Stan1806/AquaController_2014/Sources/AquaControl 2014 (MFC)/AquaControl 2014/about.bmp

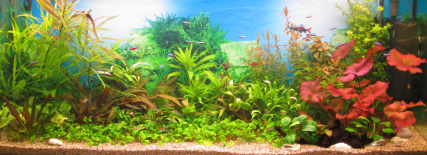
Sources/AquaControl 2014 (MFC)/AquaControl 2014/about.bmp
