Stan1806/AquaController_2014/Sources/Help/About program.png

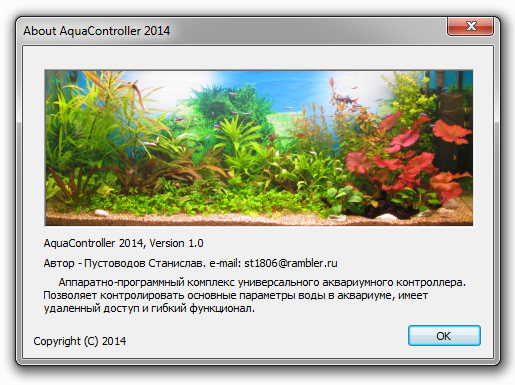
Sources/Help/About program.png
