Stan1806/AquaController_2014/Радиомодуль (схема).pdf

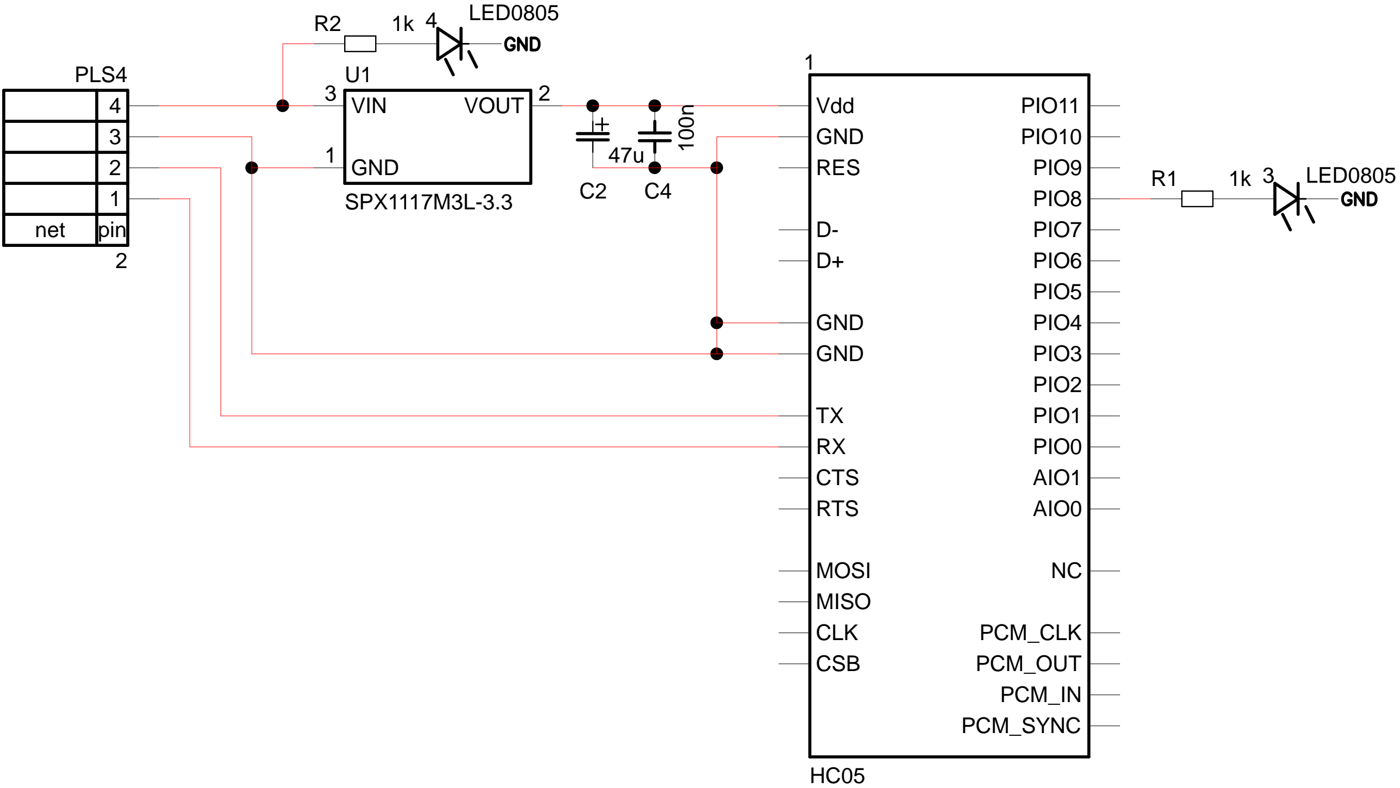
[picture p3: figure]
LED0805; GND 3; VIN; VOUT; SPX1117M3L-3.3; net; pin2; PLS4; PCM_SYNC; PCM_CLK PCM_OUT; AIO1; PIO0; PIO2; PIO3; PIO5; PIO6; PIO8; PIO9; PIO11; PCM_IN; AIO0; PIO1; PIO4; PIO7; PIO10; CLK CSB; MOSI; RX CTS; GND; RES; Vdd; MISO; RTS
