Stan1806/AquaController_2014/Техническое описание.pdf

Аппаратно-программный комплекс универсального аквариумного контроллера

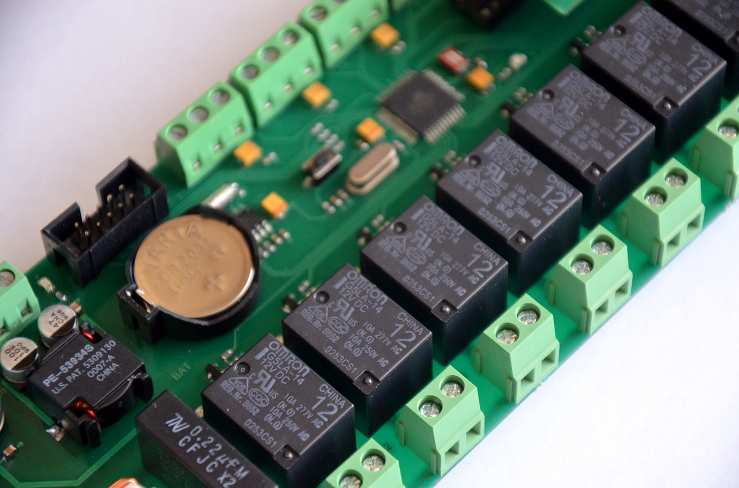
[picture p4: figure]

Данное руководство позволяет пользователю собрать комплекс и отладить его
работу, | описывает | подключение | внешних | датчиков | и | электродов, | основные
электрические | характеристики | устройства, | взаимодействие | с | программным
обеспечением и другую информацию, необходимую для установки и обслуживания.
Текущее | руководство | описывает | работу | устройства, | использующего
низкоуровневое программное обеспечение (прошивку) версии 1.0 и программу AquaController 2014 версии 1.0.

Пустоводов С.А.
Pustovodov1988@gmail.com | 2014 год.

Краткое описание комплекса.

Комплекс состоит из внешнего устройства и программного обеспечения для ПК, осуществляющее мониторинг, управление и сбор информации о параметрах воды в аквариуме.

Версия 1.0 - Первая версия программного обеспечения AquaController 2014. Совместима с прошивкой устройства версии 1.0. AquaController 2014 предусматривает управление 8 каналами (+ ШИМ канал):

- 4 канала освещения;
- компрессор;
- нагреватель (до 300 Вт.);
- электроклапан системы CO2;
- помпа/электроклапан автодолива;
- кулера 12 в.

Удаленное управление организовано по средствам протокола RS-232. Физический канал реализован по средствам переходника COM - USB CP2102, либо по радиоканалу, используя модуль HC-05 (Bluetooth). Возможно подключение 3 температурных датчиков DS18B20, PH и Redox-электродов, датчика уровня воды, 4-х строчного ЖКИ на контроллере HD44780. Для текущего времени использовались часы реального времени DS1307Z. Программное обеспечение предусматривает 4 автоматических режима: температурный режим, режим PH/CO2, режим вентиляции крышки, режим автодолива воды. Аппаратно-программный комплекс так же предусматривает: использование 3-х таймеров на каждый канал, с возможностью посекундной установки интервалов; ручной режим; ограничивающие временные интервалы для подсветки ЖКИ, работы кулеров и системы СО2; запись данных в энергонезависимую память контроллера и другие настройки системы. Суммарная мощность коммутируемой нагрузки 650 Вт. При отключении в силовой части устройства входящего LC-фильтра и предохранителя можно увеличить коммутируемую нагрузку вдвое – до 1300 Вт. Однако делать это не рекомендуется.

ОСТОРОЖНО! Устройство имеет подключение к электросети 220В. Во время работы не прикасайтесь к токоведущим частям конструкции.

В последующих версиях будет добавлена функция записи параметров в лог-файл, изменены некоторые элементы управления и исправлены возможные ошибки, если таковые будут выявлены во время работы комплекса.

Лицензионное | соглашение. | Печатная | плата | устройства, | низкоуровневое
программное обеспечение (прошивка МК), программное обеспечение AquaController 2014, техническая документация по сборке и отладке комплекса и другие файлы, связанные с устройством - интеллектуальная собственность автора. Использование файлов в коммерческих целях - запрещено! Изменение файлов и их дальнейшее использование без указания автора - запрещено! За все бесплатно предоставляемые файлы автор не несет никакой ответственности за возможный ущерб.

Работа программного обеспечения проверена на ОС Windows XP, Windows Vista, Windows 7 (32/64 bit).

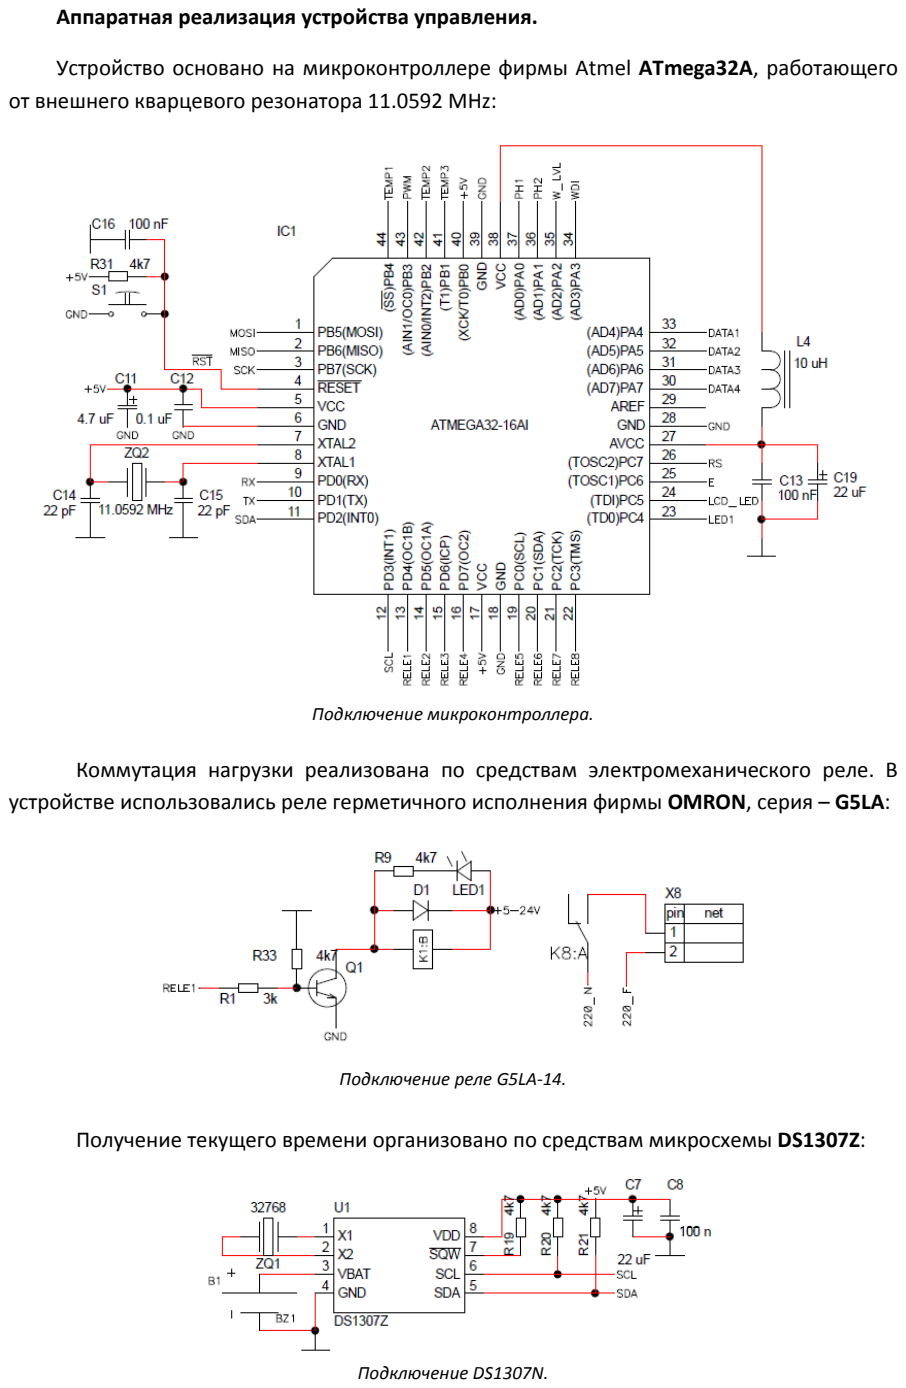
[picture p5: page 3]

Аппаратная реализация устройства управления.

Устройство основано на микроконтроллере фирмы Atmel ATmega32A, работающего от внешнего кварцевого резонатора 11.0592 MHz:

Подключение микроконтроллера.

Коммутация нагрузки реализована по средствам электромеханического реле. В устройстве использовались реле герметичного исполнения фирмы OMRON, серия – G5LA:

Подключение реле G5LA-14.

Получение текущего времени организовано по средствам микросхемы DS1307Z:

Подключение DS1307N.

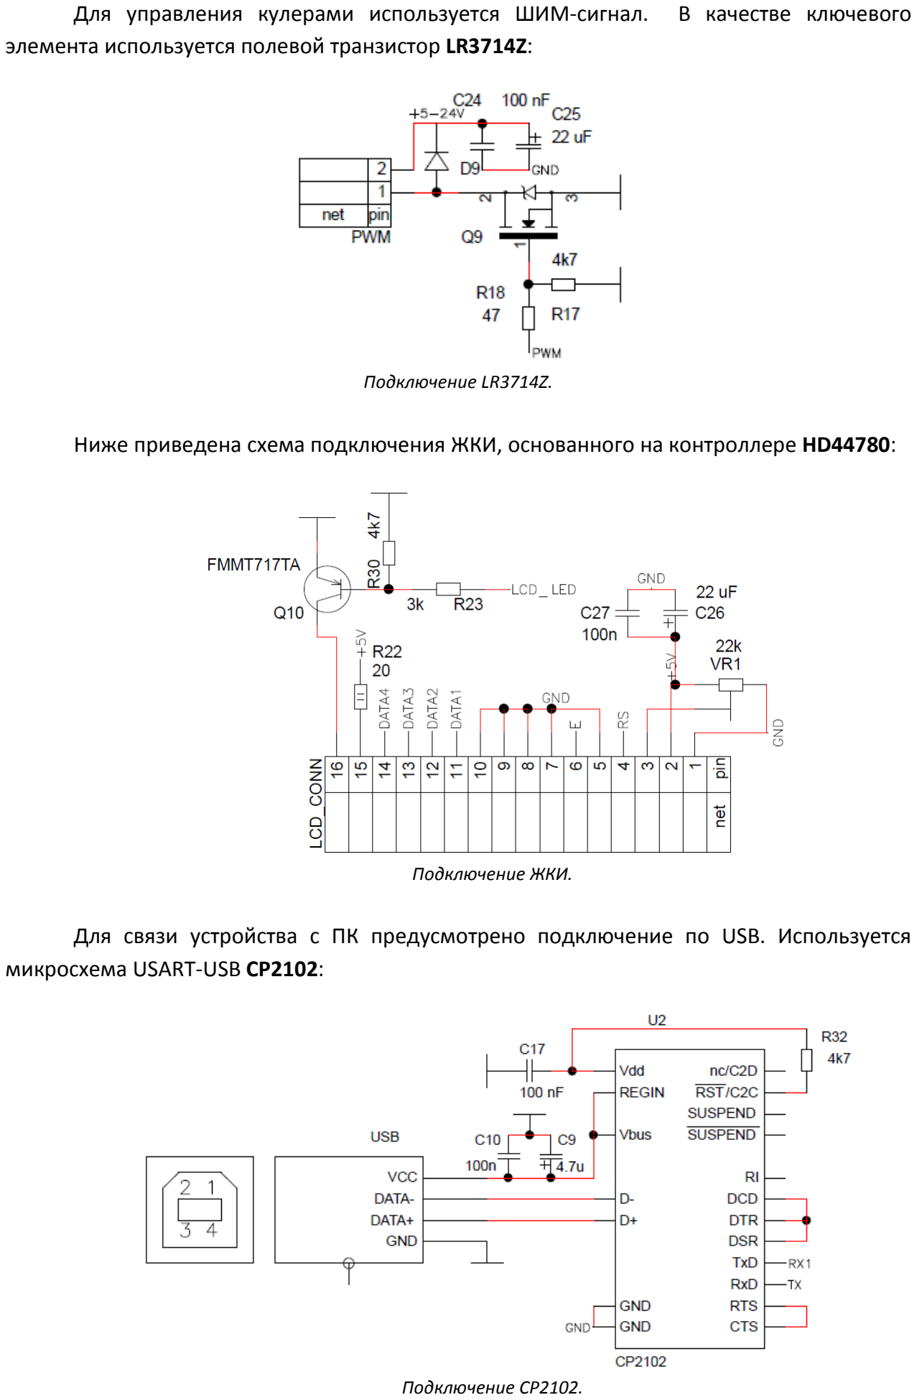
[picture p6: page 4]

Для управления кулерами используется ШИМ-сигнал. В качестве ключевого элемента используется полевой транзистор LR3714Z:

Подключение LR3714Z.

Ниже приведена схема подключения ЖКИ, основанного на контроллере HD44780:

Подключение ЖКИ.

Для связи устройства с ПК предусмотрено подключение по USB. Используется микросхема USART-USB CP2102:

Подключение CP2102.

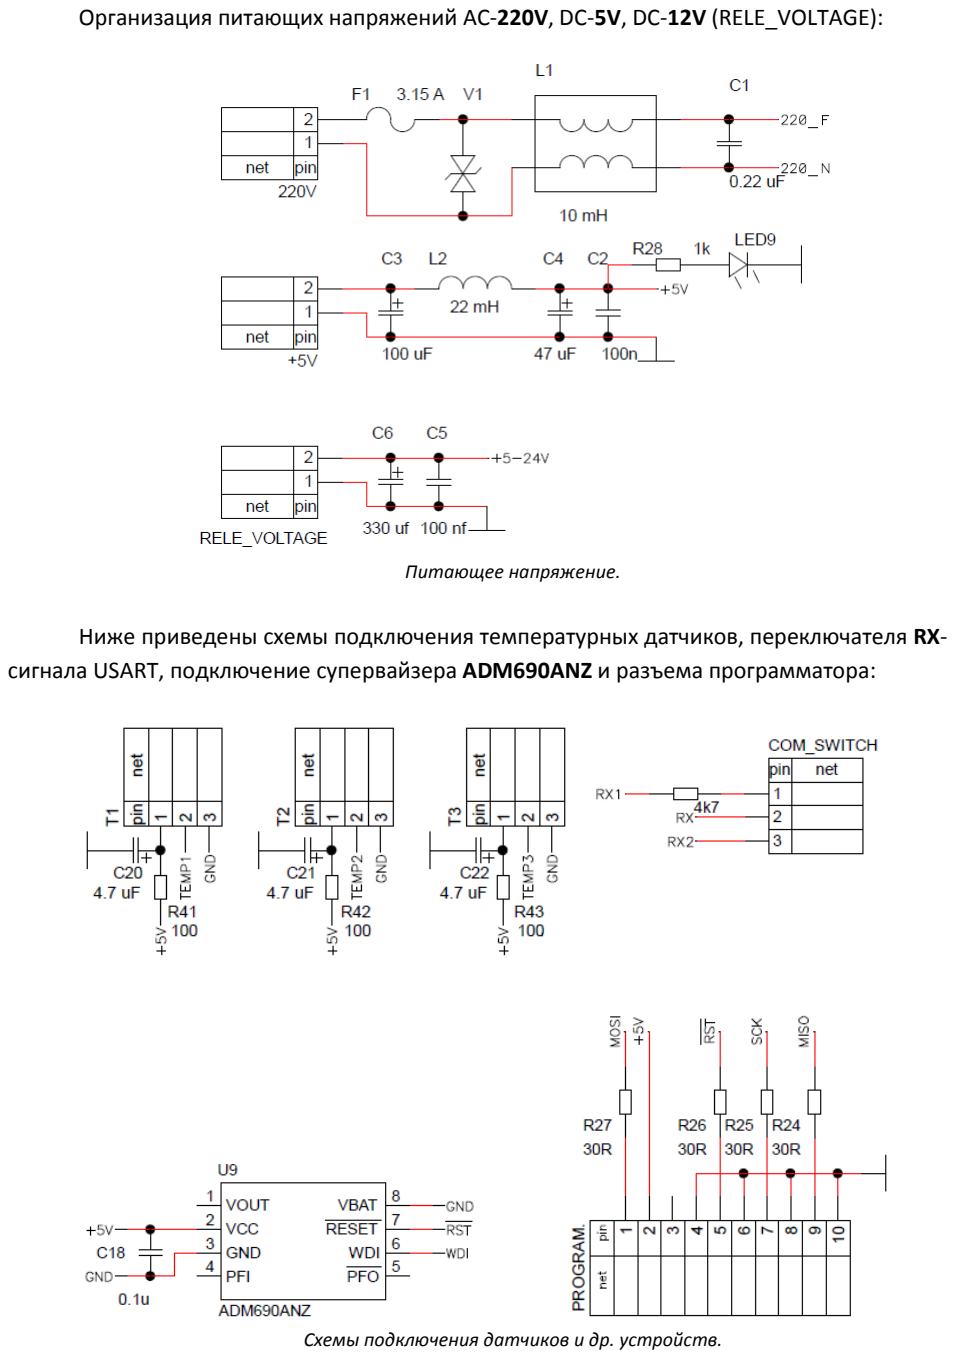
[picture p7: page 5]

Организация питающих напряжений AC-220V, DC-5V, DC-12V (RELE_VOLTAGE):

Питающее напряжение.

Ниже приведены схемы подключения температурных датчиков, переключателя RX-сигнала USART, подключение супервайзера ADM690ANZ и разъема программатора:

Схемы подключения датчиков и др. устройств.

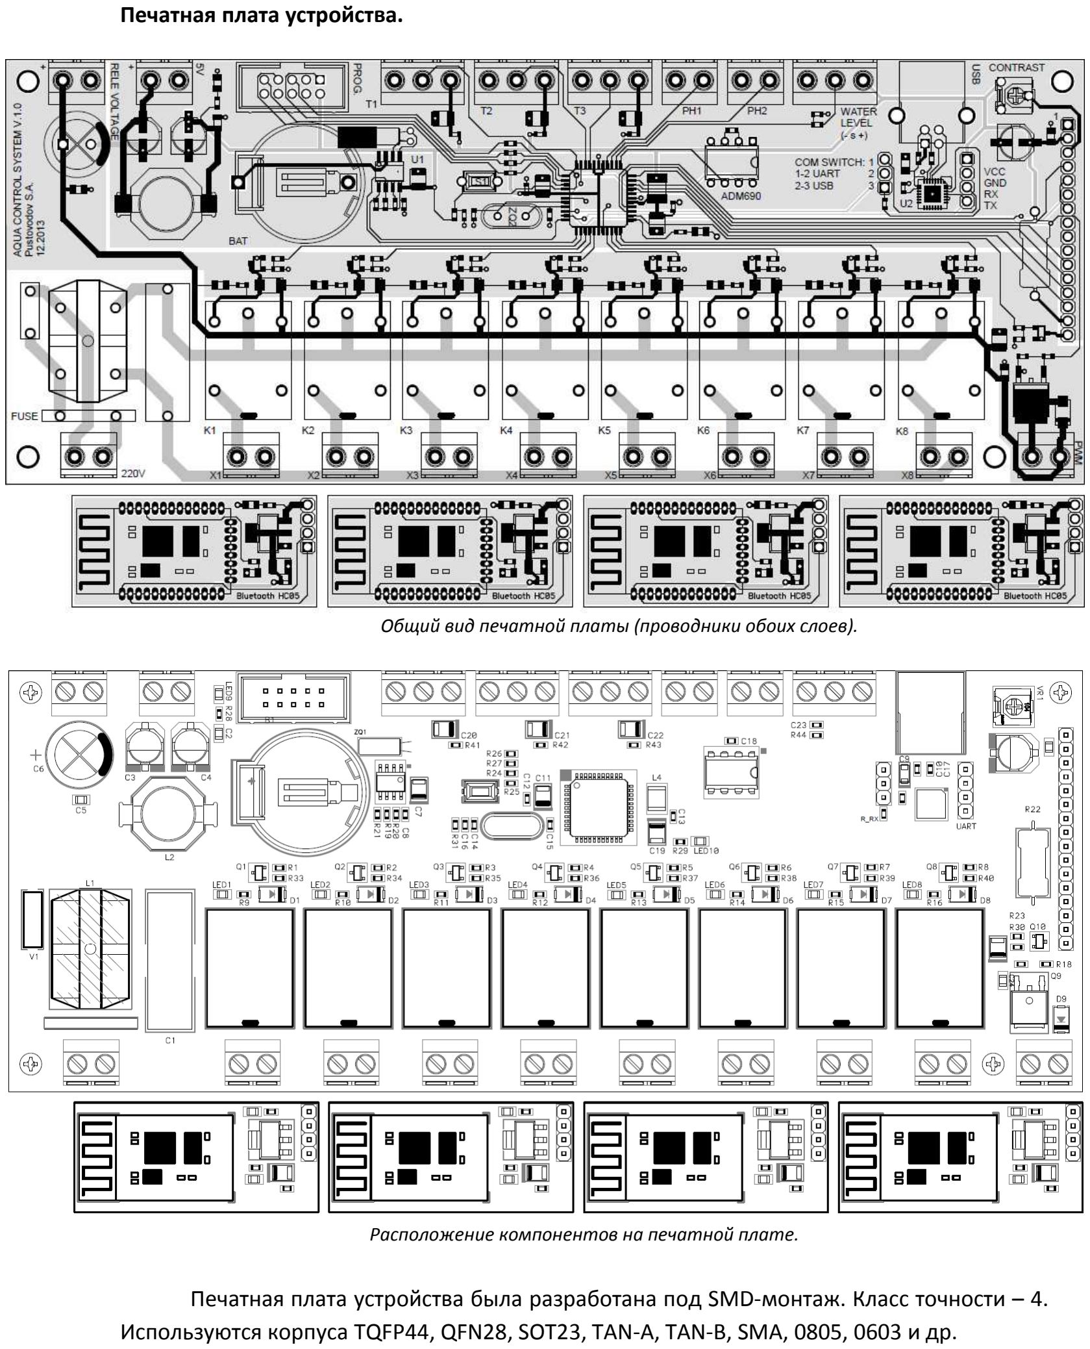
[picture p8: page 6]

Печатная плата устройства.

Общий вид печатной платы (проводники обоих слоев).

Расположение компонентов на печатной плате.

Печатная плата устройства была разработана под SMD-монтаж. Класс точности – 4. Используются корпуса TQFP44, QFN28, SOT23, TAN-A, TAN-B, SMA, 0805, 0603 и др.

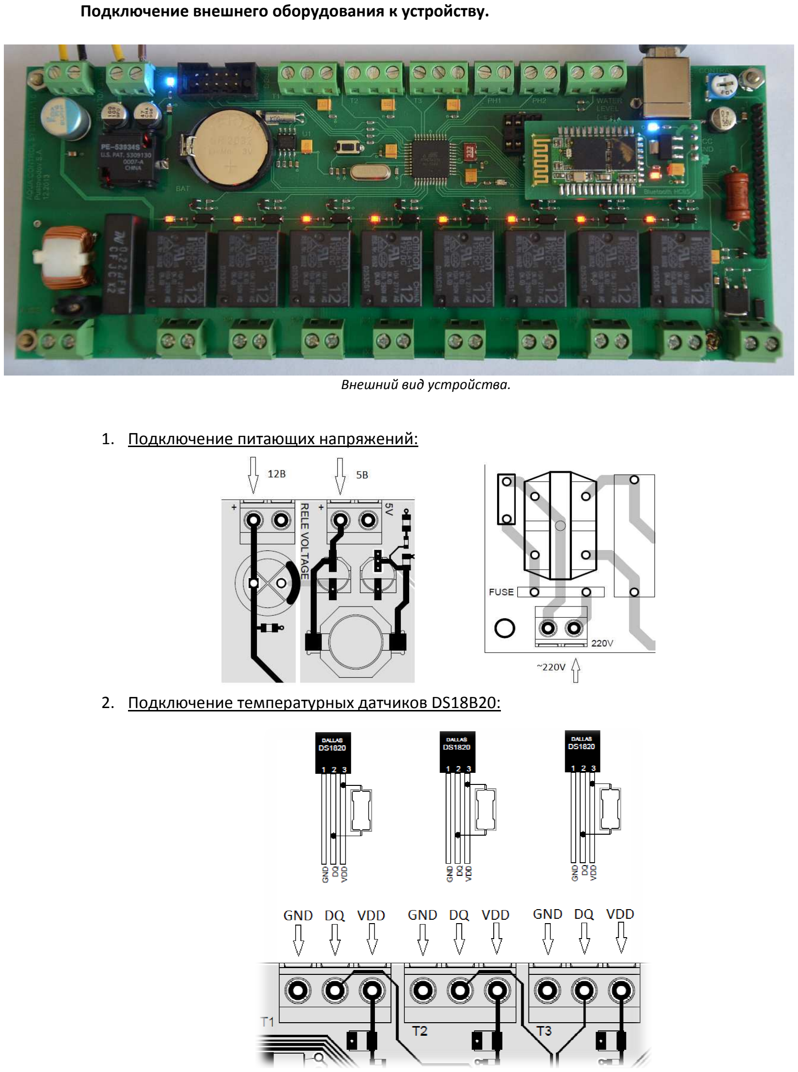
[picture p9: page 7]

Подключение внешнего оборудования

### 1. Подключение питающих напряжений:

### 2. Подключение температурных датчиков

к устройству.

Внешний вид устройства.

питающих напряжений:

DS18B20:

Терминирование | температурных | датчиков
производить в непосредственной близости от датчика. подключить сигнальный
Перед погружнием датчиков в воду их необходимо заге

### 3. Подключение электродов

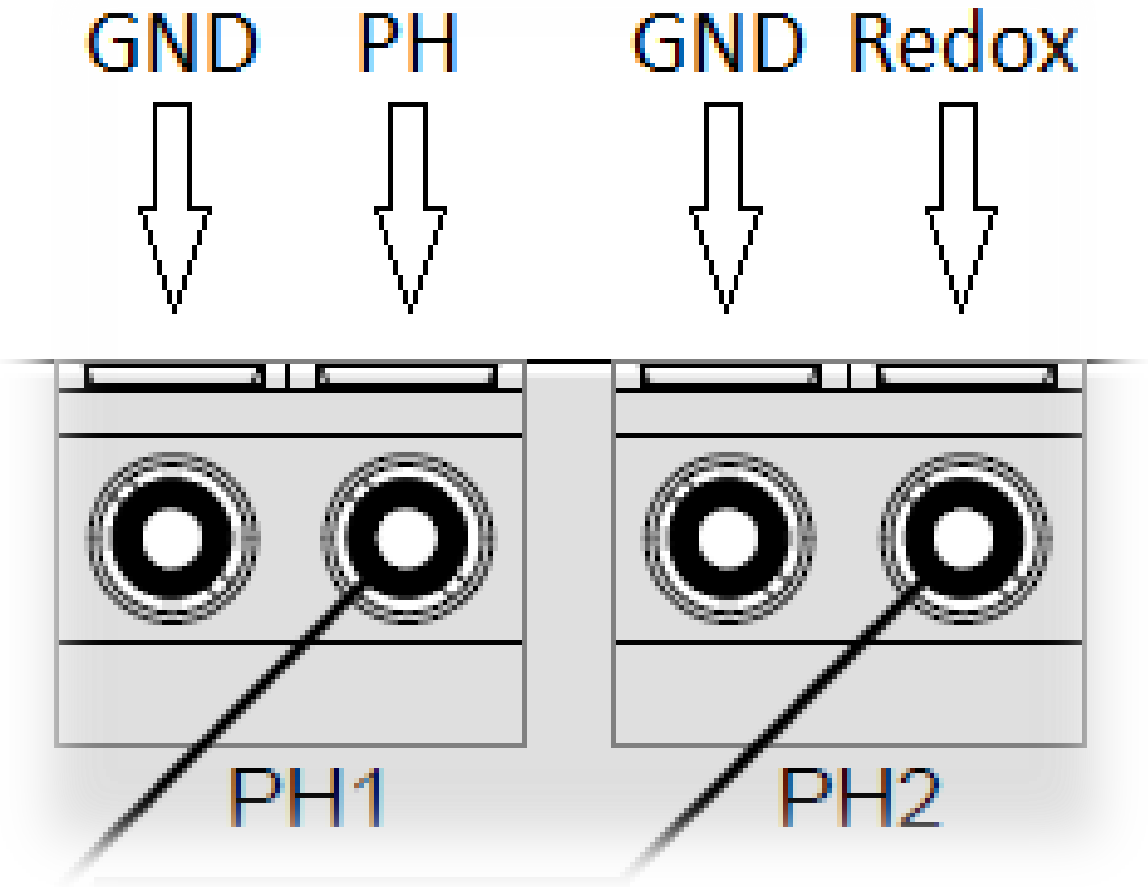
[picture p10: figure]
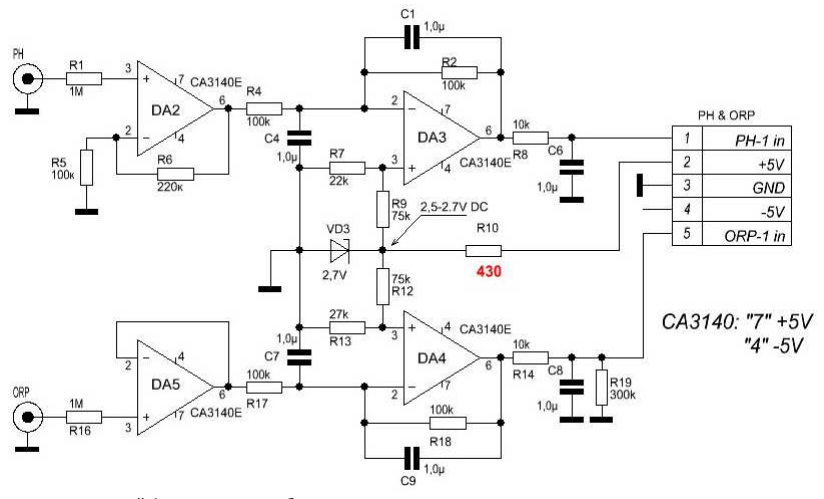
[picture p11: figure]

Текущий фрагмент схемы был взят с технического опис

### 4. Подключение кулеров

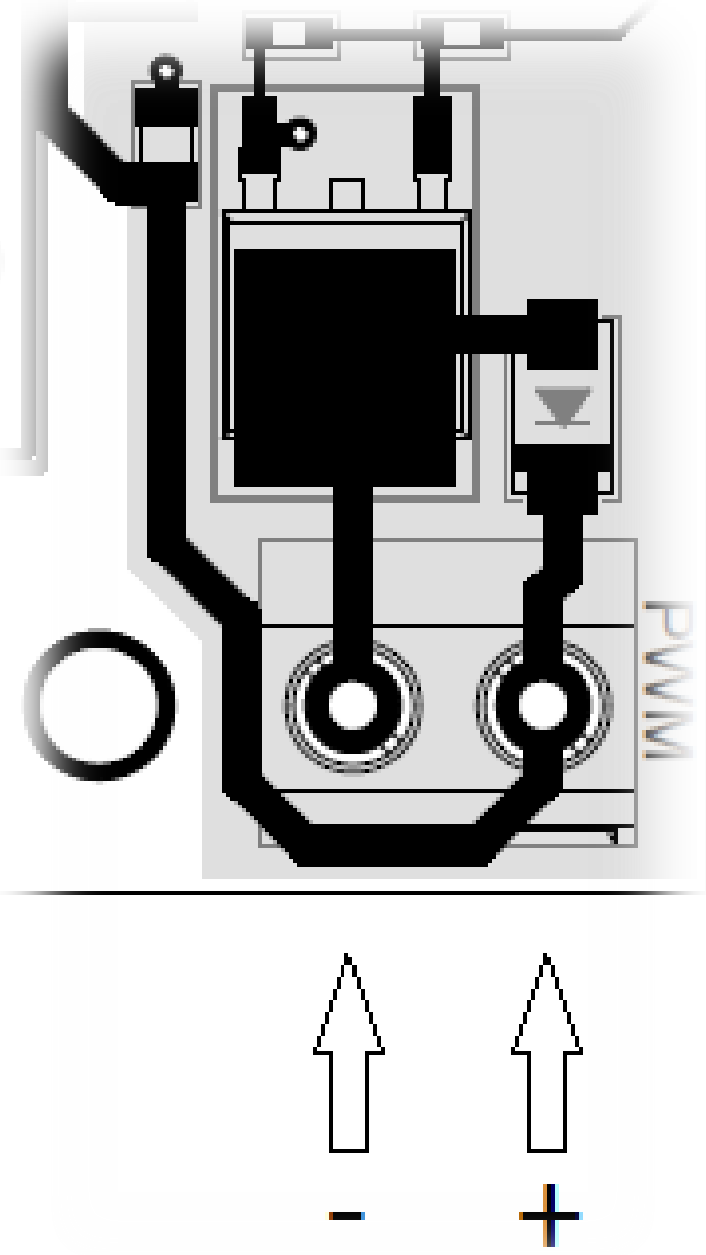
[picture p12: figure]

Текущий разъем позволяет использовать несколько кул подключенных параллельно. Этот разъем используется подключения кулеров продувки крышки, так и для охла кулеров температурного режима работы устройства.

Питающее напряжение
напряжением используемых реле и
VOLTAGE
Терминирование | температурных | датчиков | DS
производить в непосредственной близости от датчика. Для этого необходимо вывод датчика к питающему выводу через резистор 4к7 Перед погружнием датчиков в воду их необходимо загермитизировать.

PH и Redox:

Для стабильной работы электродов используйте раздельное расположение силовой части (ЭПРА, помпы др. реактивную нагрузку) и устройства управления. Используйте стабилизированные источники питания. Для подключения электродов используется плата
усиления | сигнала, | основанная | на | операционном
усилителе CA3140E:

Текущий фрагмент схемы был взят с технического описания акваконтроллера

12В:

Текущий разъем позволяет использовать несколько кул подключенных параллельно. Этот разъем используется подключения кулеров продувки крышки, так и для охла кулеров температурного режима работы устройства.

Питающее напряжение для кулеров совмещено с питающим напряжением используемых реле и подается через

DS18B20 необходимо
Для этого необходимо
рмитизировать.

и

А.Юсупова.

еров 12В.,
как для
ждающих

совмещено с питающим
разъем RELE

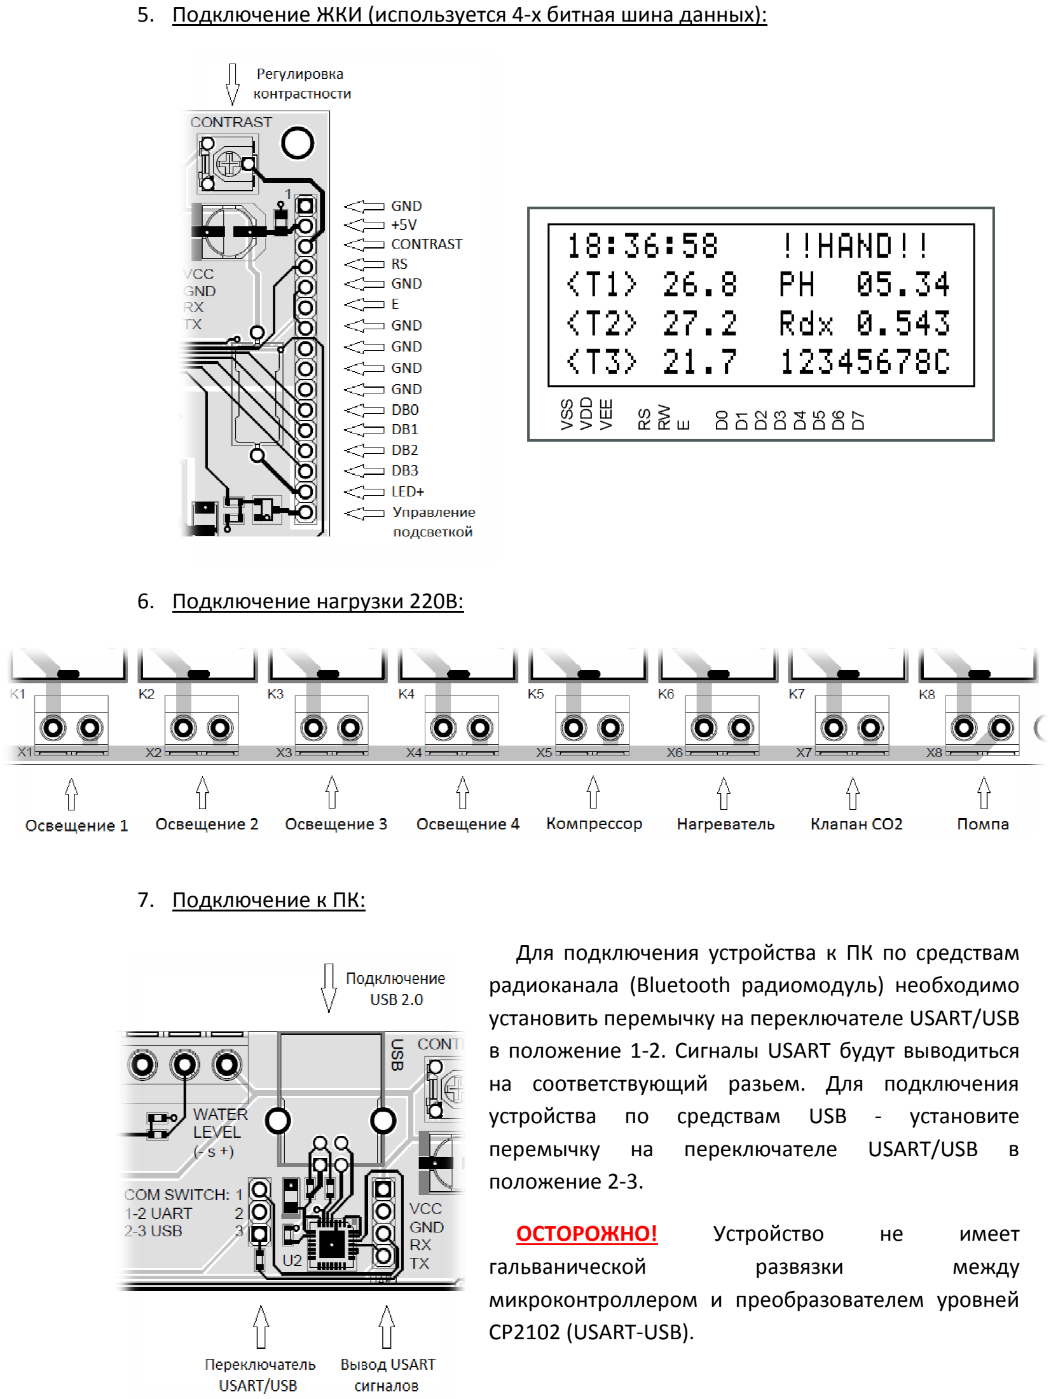
[picture p13: page 9]

### 5. Подключение ЖКИ

### 6. Подключение нагрузки

### 7. Подключение к ПК:

(используется 4-х битная шина данных):

220В:

Для подключения устройства к ПК по средствам радиоканала (Bluetooth радиомодуль
установить перемычку на переключателе
в положение 1-2. Сигналы USART
на соответствующий разьем
устройства | по | средствам
перемычку | на | переключателе
положение 2-3.
ОСТОРОЖНО! | Устройство | не | имеет
гальванической | развязки
микроконтроллером и преобразователем уровней CP2102 (USART-USB).

радиомодуль) необходимо
USART/USB
USART будут выводиться
. Для подключения
USB | - | установите
USART/USB | в
Устройство | не | имеет
| | между

При подключении по средствам
используемый для получения +5В, и питащее напряжени
электросети (розетку). В ином случае возможна некорректная работа устрой строя определенных элементов конструкции. Основным предусмотрен радиоканал,

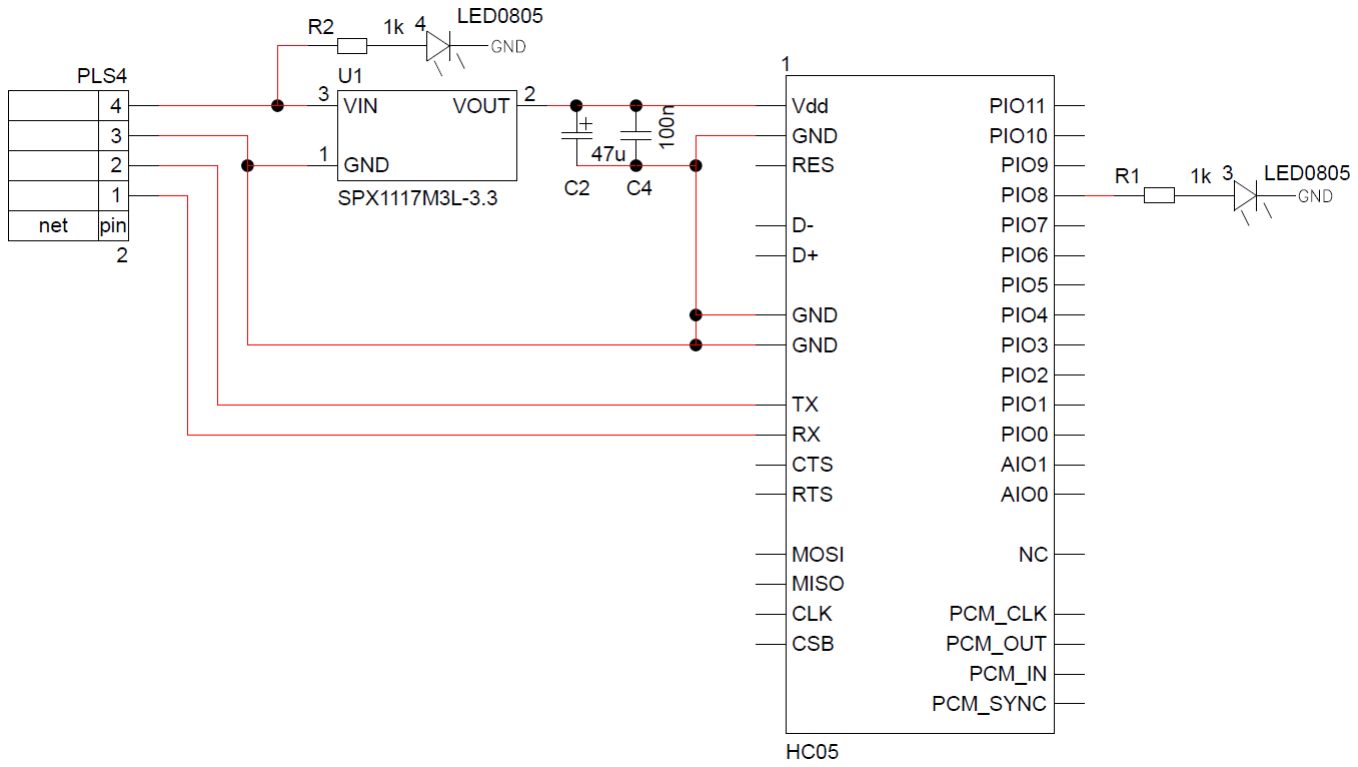
[picture p14: figure]
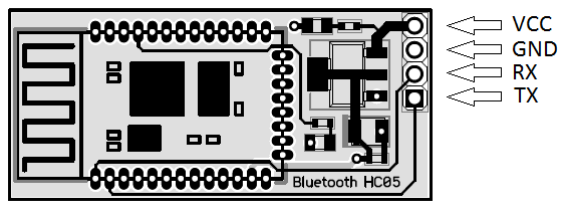
[picture p15: figure]

### 8. Подключение датчика уровня воды:

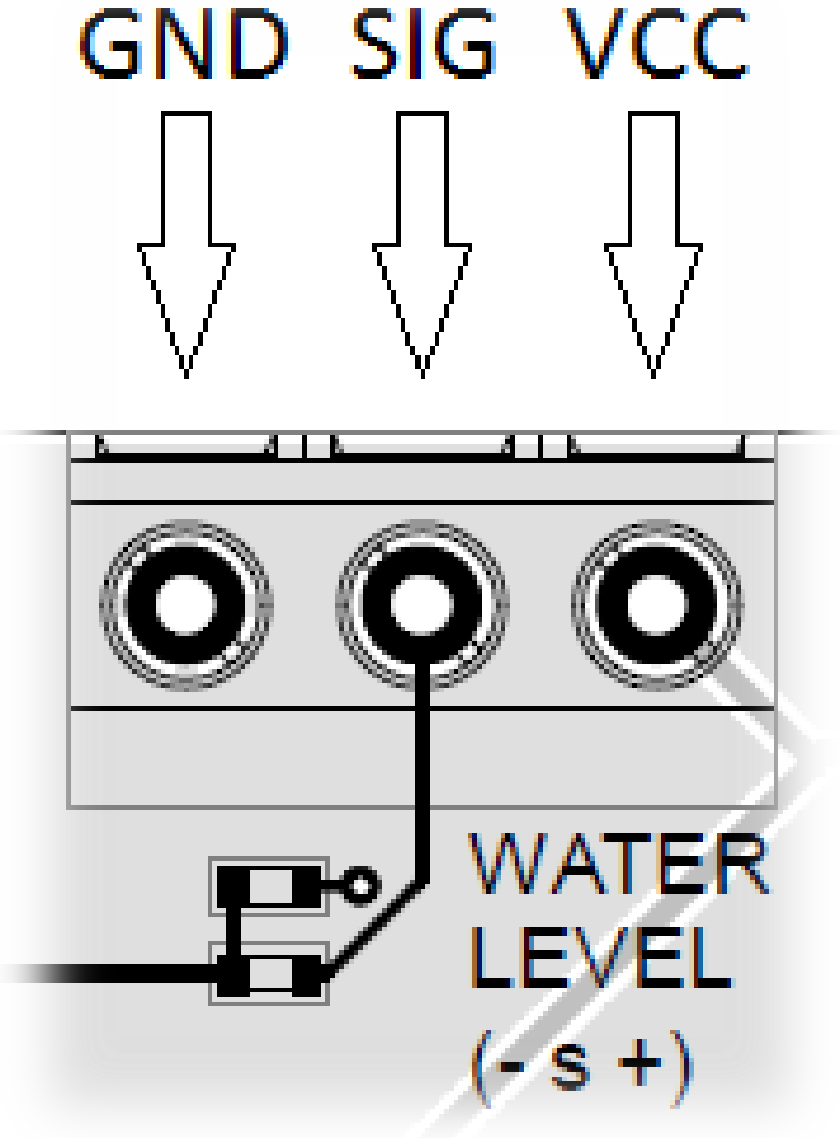
[picture p16: figure]

Датчик уровня воды должен иметь
быть система, использующая какой
выходом, | либо | же | поплавковая | система, | подключенная
герметичному переменному резистору. Или же любой др имеющий на выходе аналоговый сигнал. Такой подход п постоянно отслеживать значение датчика и сравнивать предыдущими значениями, что дает представление об и датчика уровня воды. Это позволяет избежать главног текущего режима
датчиков/микрик

USB убедитесь, что источник электропитания, е ПК включены в один узел
. В ином случае возможна некорректная работа устрой каналом свя
USB-подключение – резервное.

Схема радиомодуля Bluetooth.

Печатная плата радиомодуля Bluetooth.

Датчик уровня воды должен иметь аналоговый
быть система, использующая какой-либо дальномер с аналоговым
выходом, | либо | же | поплавковая | система, | подключенная
герметичному переменному резистору. Или же любой др
имеющий на выходе аналоговый сигнал. Такой подход п остоянно отслеживать значение датчика и сравнивать предыдущими значениями, что дает представление об и
датчика уровня воды. Это позволяет избежать главног текущего режима - перелива воды в аквариуме при не исправности датчиков/микриков.

что источник электропитания, е ПК включены в один узел
ства, выход из
каналом связи комплекса

выход. Это может
либо дальномер с аналоговым к
угой метод,
озволяет
его с
справности
о риска

Программирование микроконтроллера.

Для | загрузки | низкоуровневого | программного | обеспечения | (прошивки) | в
микроконтроллер | использовался | программный | продукт | AVR | Studio | 4.19.
Использовался программатор AVR910. Схема программатора и программное обеспечение доступно для бесплатного использования и может быть загружено с официального сайта Atmel http://www.atmel.com. Может быть использовано любое программное обеспечение и программатор, поддерживающие программирование по последовательному периферийному интерфейсу (SPI).

Подключите программатор к устройству (разъем PROG.). Подключите программатор к ПК. Запустите AVR Studio, зайдите в меню Tools/Options/General и в графе Number of COM-ports to try укажите номер COM-порта, присвоенного программатору системой.

Для подключения к программатору зайдите в меню Tools/AVR Prog… В графе Device выберите микроконтроллер ATmega32. Для установки фьюзов нажмите кнопку Advanced… Снимите галочку с опции JTAG Enable, и выбирете тип резоната с временными интервалами – Ext XTAL, Startup: 30us + 16K CK. После чего нажмите кнопку Write. Закройте окно Advenced. В окне AVRprog нажмите кнопку Browse… и укажите путь к файлу прошивки firmware_v.1.0.hex. После чего в графе Flash нажмите кнопку Program. Дождитесь завершения загрузки и проверки содержимого флеш-памяти микроконтроллера. Закройте программу и отключите программатор.

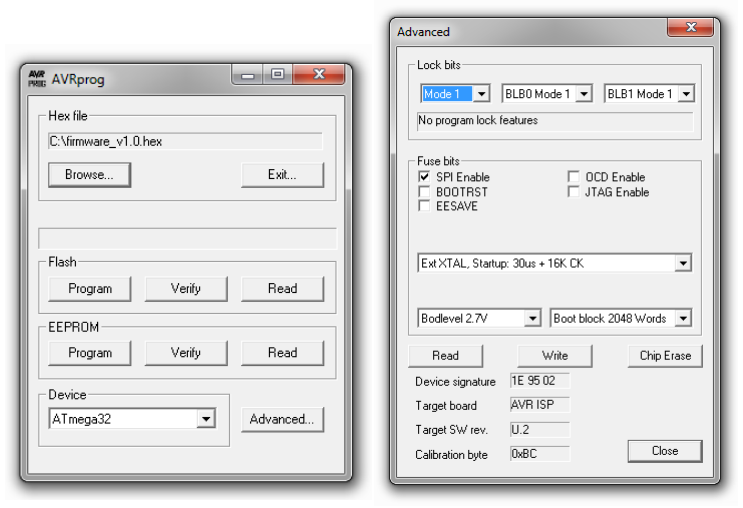
[picture p17: figure]

Окна программатора AVRprog.

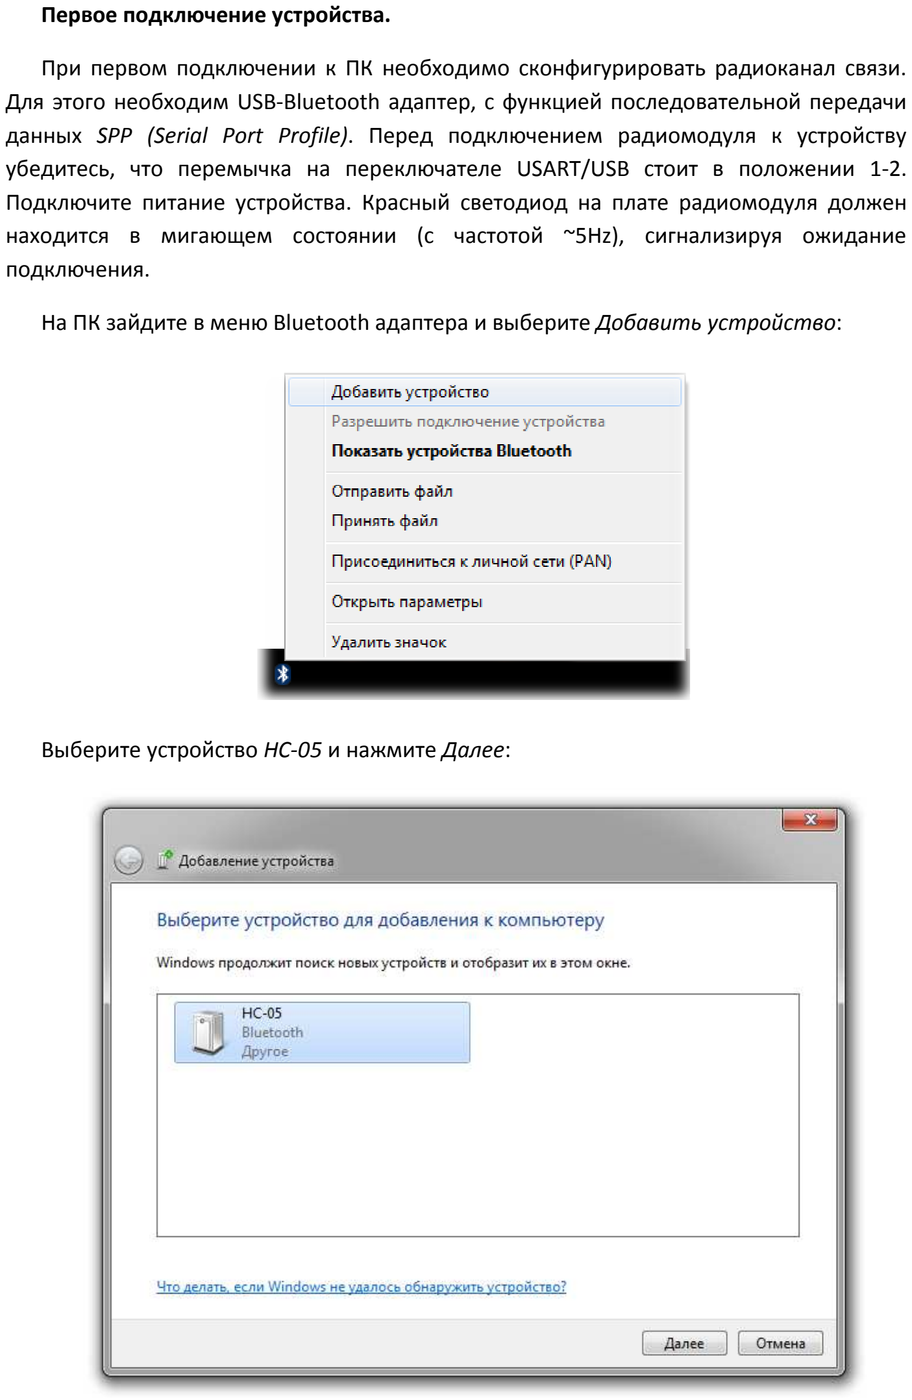
[picture p18: page 12]

Первое подключение устройства.

При первом подключении к ПК необходимо сконфигуриро Для этого необходим
данных SPP (Serial Port
убедитесь, что перемычка на переключателе
Подключите питание устройства. Красный светодиод на находится в мигающем состоянии
подключения.

На ПК зайдите в меню

Выберите устройство

При первом подключении к ПК необходимо сконфигурировать радиоканал связи. USB-Bluetooth адаптер, с функцией последовательной передачи Port Profile). Перед подключением радиомодуля к устройству USART/USB стоит в положении плате радиомодуля должен
(с частотой ~5Hz), сигнализ

Bluetooth адаптера и выберите Добавить устройство

HC-05 и нажмите Далее:

вать радиоканал связи.

стоит в положении 1-2.
плате радиомодуля должен
ируя ожидание

Добавить устройство:

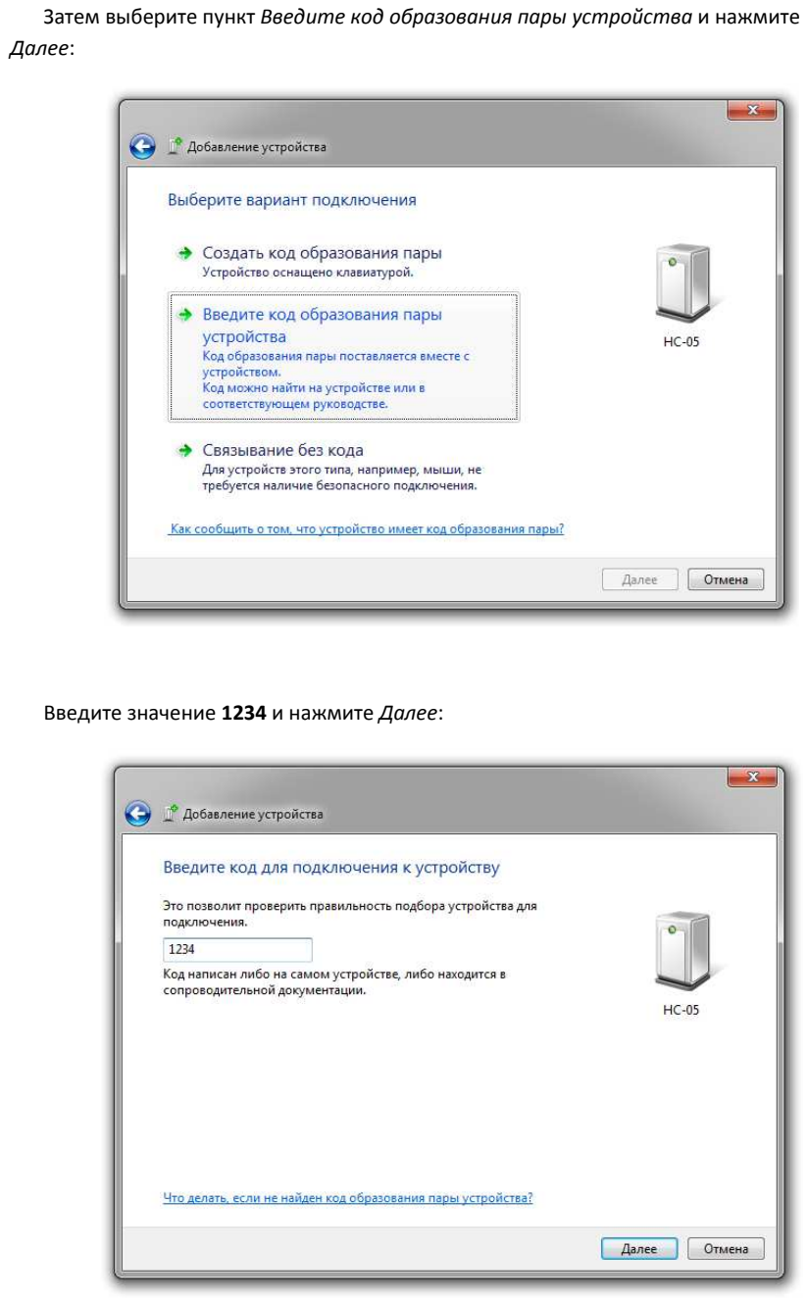
[picture p19: page 13]

Затем выберите пункт Введите код образования пары устройства и нажмите Далее:

Введите значение 1234 и нажмите Далее:

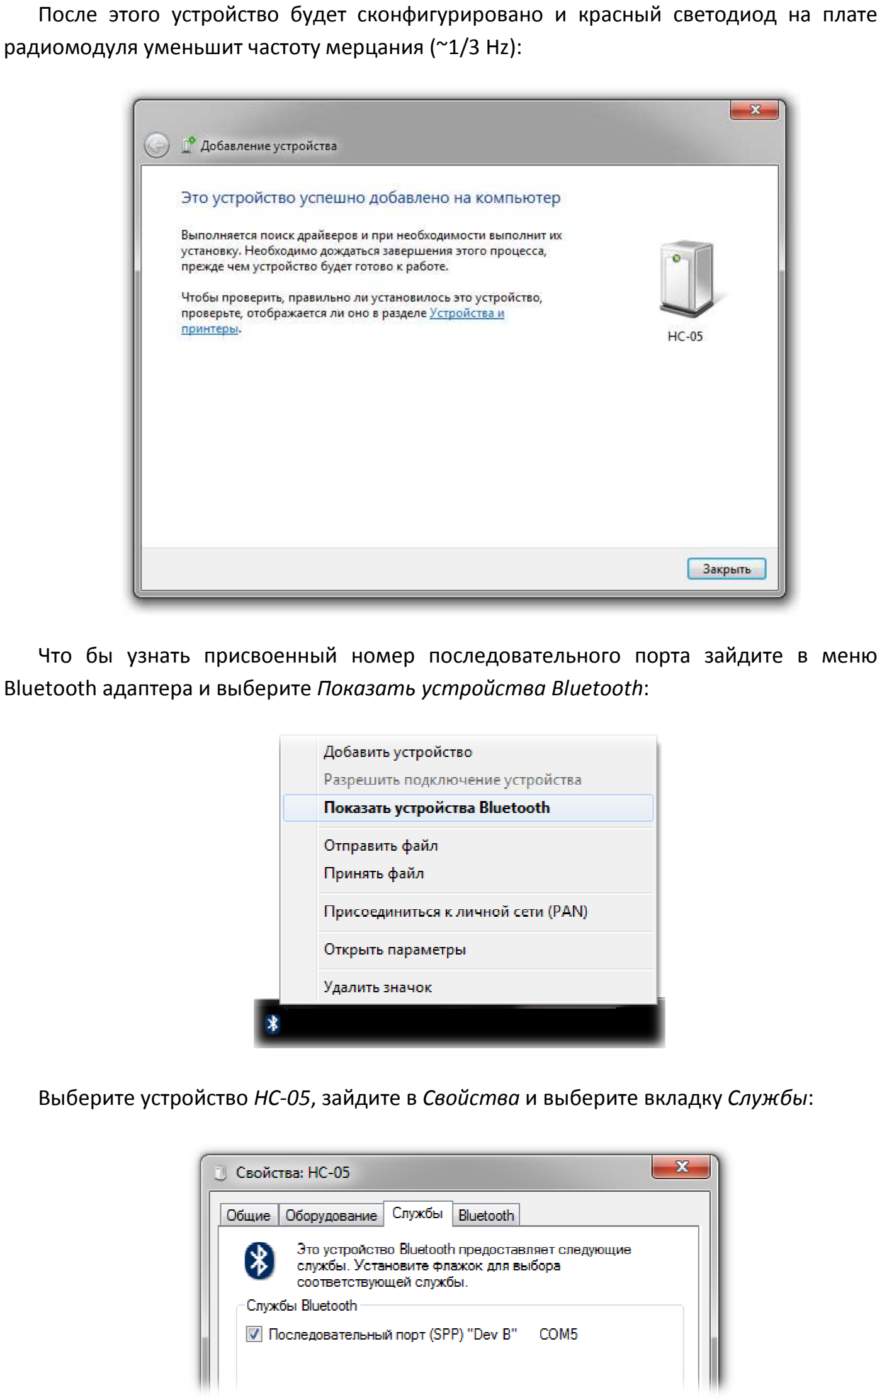
[picture p20: page 14]

После этого устройст
радиомодуля уменьшит

Что бы узнать присвоенный номер последовательного п Bluetooth адаптера и выбе

Выберите устройство

во будет сконфигурировано и красный с частоту мерцания (~1/3 Hz):

Что бы узнать присвоенный номер последовательного п рите Показать устройства Bluetooth

HC-05, зайдите в Свойства и выберите вкладку

ветодиод на плате

орта зайдите в меню
:

Службы:

При подключении устройства по средствам резервного перемычка на переключателе
электропитания, используемый для получения +5В, пит
в один узел электросети (розетку).
кабель к ПК. При первом подключении диспетчер устро устройство и сделает запрос на установку драйвера д Драйвера доступны для бесплатного использования и м
официального | сайта
http://www.silabs.com/products/mcu/pages/usbtouartb

После успешной установки драйвера система определит номер последовательного порта:

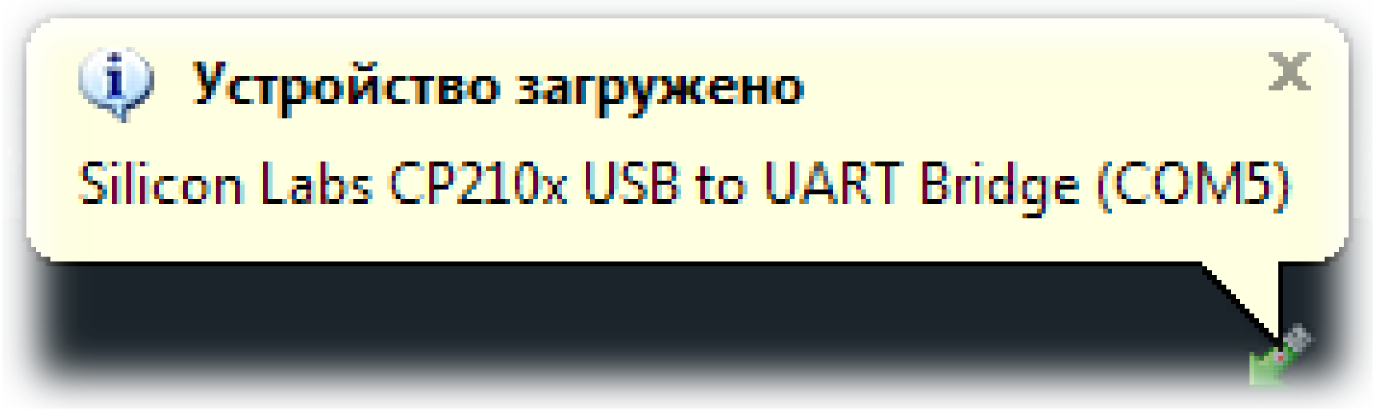
[picture p21: figure]

Если во время подключения устройства к ПК был задан порта, превышающий диапозон номеров, доступных в пр AquaController 2014 (до
системе все неиспользуемые п
неиспользуемых ресурсов произведите следующие дейст

### 1. Зайдите в м

### 2. В командной строке

нажмите Enter:

Set devmgr_show_nonpresent_devices=1

3. В командной строке введите команду запуска Диспетче В командной строке введите команду запуска Диспетче | ра задач и нажмите
Enter:

Devmgmt.msc

В открывшемся окне Диспетчера задач в меню шемся окне Диспетчера задач в меню Вид выберите пункт | ите пункт - Отображать
скрытые устройства. | | Устройства, отмеченные серым цветом (затененные), к | ак
правило, старые или неиспользуемые и их можно | корректно для ОС удалить, щелкнув для ОС удалить, щелкнув
на них правой кнопкой и выбра | в пункт - Удалить.

После удаления неиспользуемых последовательных порт
повторное подключение устройства, как было описано

При подключении устройства по средствам резервного USB USART/USB стоит в положении 2
ащее напряжение ПК включены Подключите кабель к устройству, затем подключите йств об
ля преобразователя
огут
производителя | для | используемой | ОС
ridgevcpdrivers.aspx

После успешной установки драйвера система определит устройство и назначит ему

Если во время подключения устройства к ПК был задан номер последовательного ограммном обеспечении
(до 9 портов), необходимо отключить устройство и удалить оследовательные порты. Для корректного удаления вия:
| еню Пуск/Все программы/Стандартные/Командная строка.
Выберите правой кнопкой мыши правой кнопкой мыши из выпадающего списка | | - Запустить от имени
Администратора.
введите команду отображения скрытых устройств и

Set devmgr_show_nonpresent_devices=1

После удаления неиспользуемых последовательных порт ранее.

-канала убедитесь, что
-3, и источник
ащее напряжение ПК включены

йств обнаружит новое
ля преобразователя CP210x. гут быть загружены с

устройство и назначит ему

номер последовательного
ограммном обеспечении
в
Для корректного удаления

ов в ОС произведите

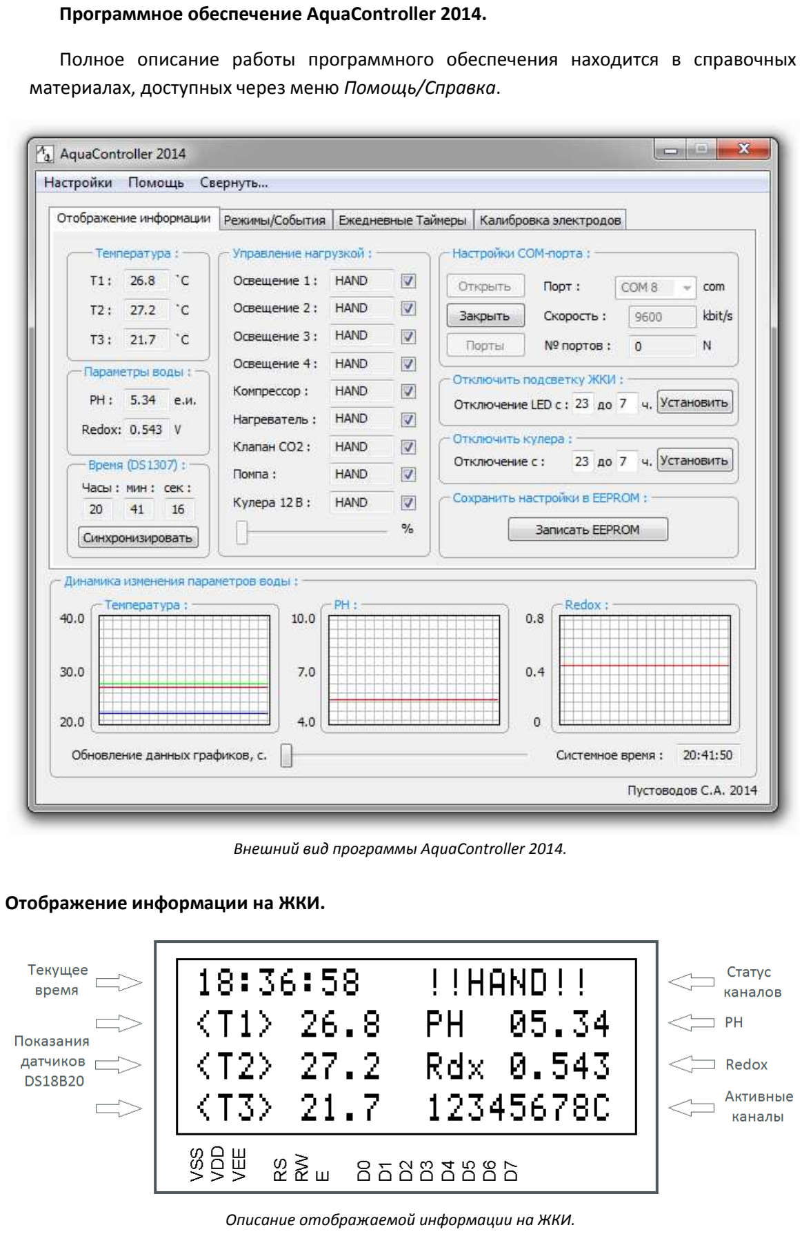
[picture p22: page 16]

Программное обеспечение AquaController 2014.

Полное описание работы программного обеспечения находится в справочных материалах, доступных через меню Помощь/Справка.

Внешний вид программы AquaController 2014.

Отображение информации на ЖКИ.

Описание отображаемой информации на ЖКИ.
