Stan1806/AquaController_2014/Sources/Help/Settings program.png

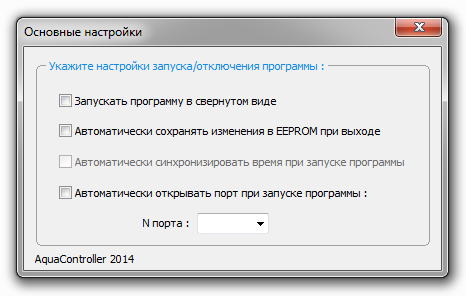
Sources/Help/Settings program.png
