Stan1806/AquaController_2014/Sources/Help/Tab1.png

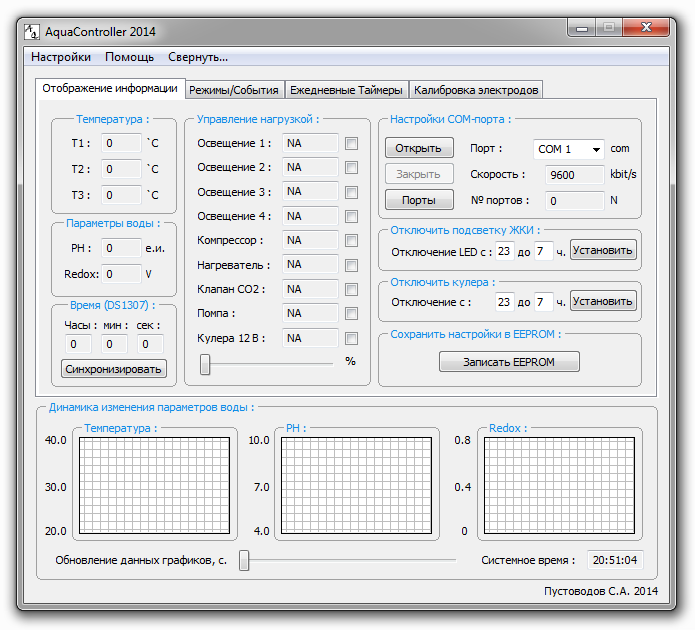
Sources/Help/Tab1.png
