Stan1806/AquaController_2014/Sources/Help/Tab2.png

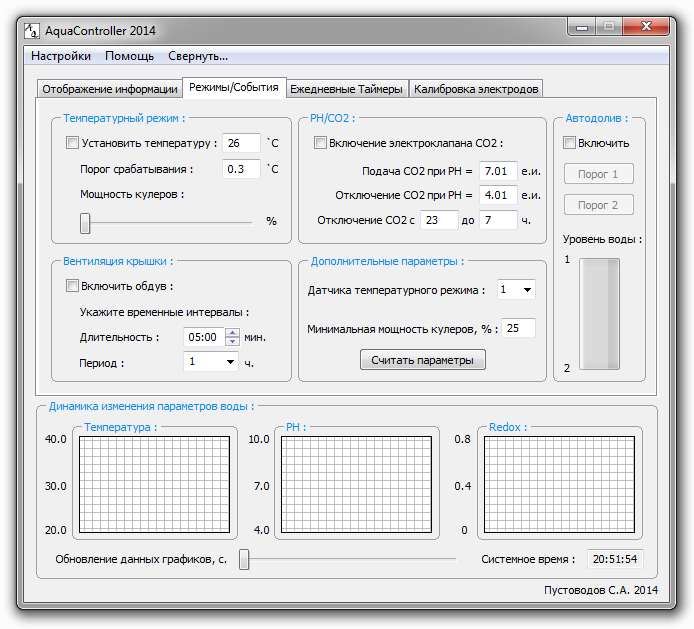
Sources/Help/Tab2.png
