Stan1806/AquaController_2014/Sources/Help/Tab3.png

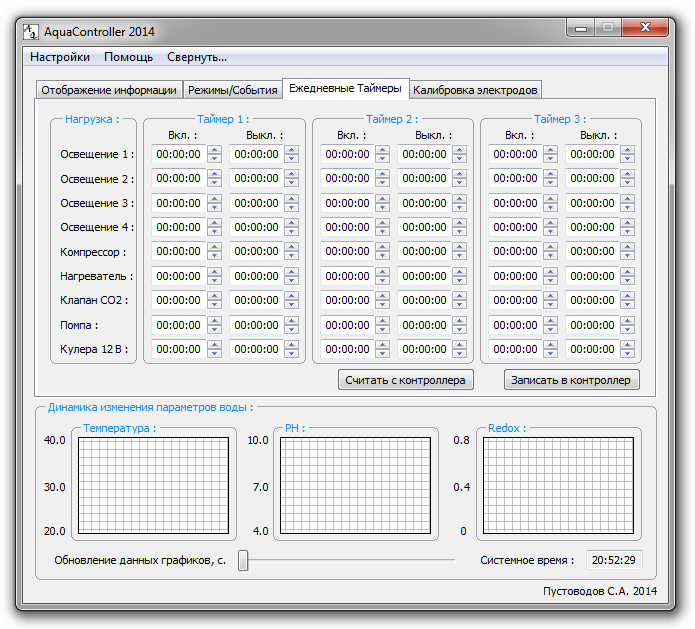
Sources/Help/Tab3.png
