Stan1806/AquaController_2014/Sources/Help/Tab4.png

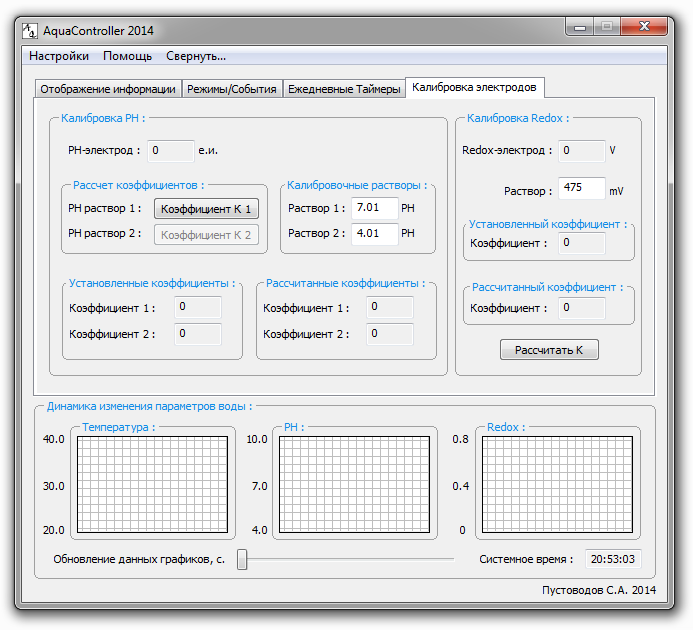
Sources/Help/Tab4.png
