Stan1806/AquaController_2014/(threads)

Thread 1 (2016-02-18):

gerber or eaglecad schem

Nurmukhamed, 2016-02-18:
Dear Stan may you create gerber files, so i can send them to pcb production fabric?

Дорогой Стэн, можете создать гербер файлы, чтобы я мог отправить их на фабрику, чтобы мне изготовили плату.
