Stan1806/AquaController_2014/Печатная плата.pdf

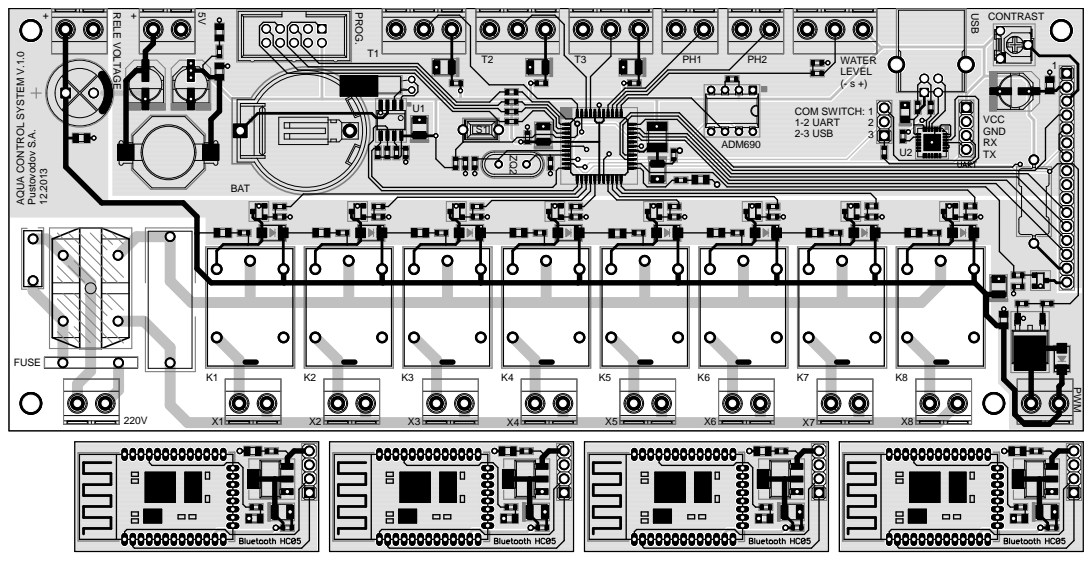
[picture p28: page 1]
BAT; VCC GND RX TX; PWM; RELE VOLTAGE; PROG.; COM SWITCH: 1-2 UART 2-3 USB; ADM690; USB; FUSE; CONTRAST; WATER LEVEL; Pustovodov S.A.

AQUA CONTROL SYSTEM V.1.0
