Stan1806/AquaController_2014/Расположение компонентов.pdf

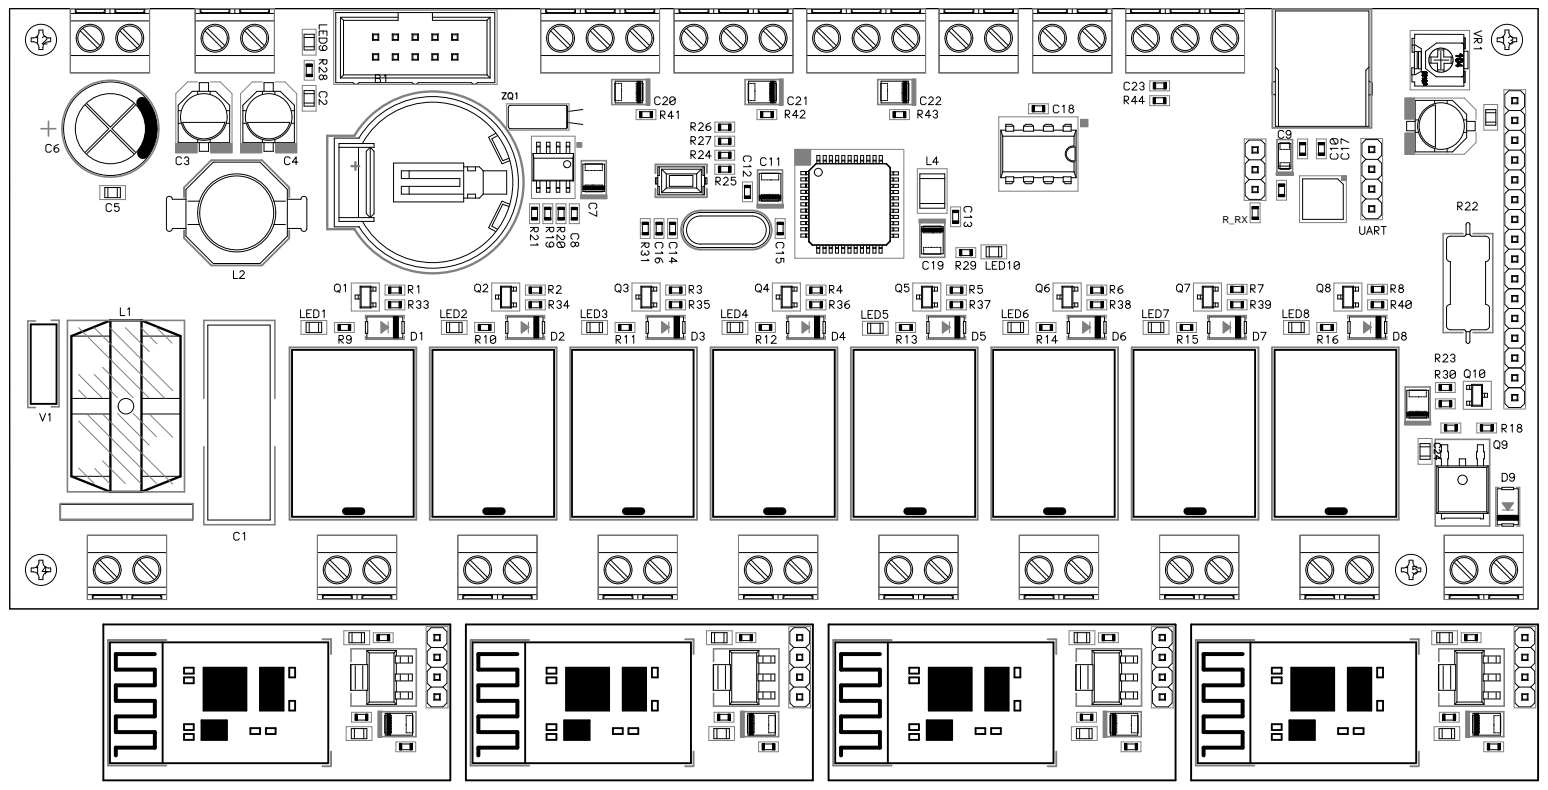
[picture p29: page 1]
