Stan1806/AquaController_2014/(list of files, drawings)

Other design files:
Sources/P-CAD/Control.pcb
Sources/Proteus/aqua.DSN
