Stan1806/AquaController_2014/Sources/AquaControl 2014 (MFC)/AquaControl 2014/AquaControl 2014.cpp

// AquaControl 2014.cpp : Defines the class behaviors for the application.
//

#include "stdafx.h"
#include "AquaControl 2014.h"
#include "AquaControl 2014Dlg.h"

#ifdef _DEBUG
#define new DEBUG_NEW
#endif


// CAquaControl2014App

BEGIN_MESSAGE_MAP(CAquaControl2014App, CWinApp)
	ON_COMMAND(ID_HELP, &CWinApp::OnHelp)
END_MESSAGE_MAP()


// CAquaControl2014App construction

CAquaControl2014App::CAquaControl2014App()
{
	// TODO: add construction code here,
	// Place all significant initialization in InitInstance
}


// The one and only CAquaControl2014App object

CAquaControl2014App theApp;


// CAquaControl2014App initialization

BOOL CAquaControl2014App::InitInstance()
{
	// InitCommonControlsEx() is required on Windows XP if an application
	// manifest specifies use of ComCtl32.dll version 6 or later to enable
	// visual styles.  Otherwise, any window creation will fail.
	INITCOMMONCONTROLSEX InitCtrls;
	InitCtrls.dwSize = sizeof(InitCtrls);
	// Set this to include all the common control classes you want to use
	// in your application.
	InitCtrls.dwICC = ICC_WIN95_CLASSES;
	InitCommonControlsEx(&InitCtrls);

	CWinApp::InitInstance();

	AfxEnableControlContainer();

	// Standard initialization
	// If you are not using these features and wish to reduce the size
	// of your final executable, you should remove from the following
	// the specific initialization routines you do not need
	// Change the registry key under which our settings are stored
	// TODO: You should modify this string to be something appropriate
	// such as the name of your company or organization
	SetRegistryKey(_T("Local AppWizard-Generated Applications"));

	CAquaControl2014Dlg dlg;
	m_pMainWnd = &dlg;
	INT_PTR nResponse = dlg.DoModal();
	if (nResponse == IDOK)
	{
		// TODO: Place code here to handle when the dialog is
		//  dismissed with OK
	}
	else if (nResponse == IDCANCEL)
	{
		// TODO: Place code here to handle when the dialog is
		//  dismissed with Cancel
	}

	// Since the dialog has been closed, return FALSE so that we exit the
	//  application, rather than start the application's message pump.
	return FALSE;
}
