Stan1806/AquaController_2014/Sources/AquaControl 2014 (MFC)/AquaControl 2014/resource.h

//{{NO_DEPENDENCIES}}
// Microsoft Visual C++ generated include file.
// Used by AquaControl 2014.rc
//
#define IDM_ABOUTBOX                    0x0010
#define IDD_ABOUTBOX                    100
#define IDS_ABOUTBOX                    101
#define IDD_AQUACONTROL2014_DIALOG      102
#define IDR_MAINFRAME                   128
#define IDD_PAGE1                       129
#define IDD_PAGE2                       130
#define IDD_PAGE3                       131
#define IDD_PAGE4                       132
#define IDR_MENU1                       136
#define IDD_DIALOG_MAIN_OPTION          137
#define IDR_POPUP_MENU                  139
#define IDB_BITMAP1                     141
#define IDC_TAB                         1000
#define IDC_EDIT_T1                     1001
#define IDC_EDIT_T2                     1002
#define IDC_EDIT_T3                     1003
#define IDC_EDIT_PH                     1004
#define IDC_EDIT_REDOX                  1005
#define IDC_EDIT_LAMP1                  1006
#define IDC_EDIT_LAMP2                  1007
#define IDC_EDIT_LAMP3                  1008
#define IDC_EDIT_LAMP4                  1009
#define IDC_EDIT_COMPRES                1010
#define IDC_EDIT_HEATER                 1011
#define IDC_EDIT_CO2                    1012
#define IDC_EDIT_MINERAL                1013
#define IDC_EDIT_POMPA                  1013
#define IDC_EDIT_COOLER                 1014
#define IDC_SLIDER_COOLER               1015
#define IDC_CHECK_LAMP1                 1016
#define IDC_CHECK_LAMP2                 1017
#define IDC_CHECK_LAMP3                 1018
#define IDC_CHECK_LAMP4                 1019
#define IDC_CHECK_COMPRES               1020
#define IDC_CHECK_HEATER                1021
#define IDC_CHECK_CO2                   1022
#define IDC_CHECK_MINERAL               1023
#define IDC_CHECK_POMPA                 1023
#define IDC_CHECK_COOLER                1024
#define IDC_EDIT_HOUR                   1025
#define IDC_EDIT_MIN                    1026
#define IDC_EDIT_SEC                    1027
#define IDC_BUTTON_SYNC                 1028
#define IDC_CHECK_TEMP_MODE             1030
#define IDC_EDIT_TEMP_SET               1031
#define IDC_EDIT_TEMP_POROG             1032
#define IDC_EDIT_COOLER_POWER           1033
#define IDC_CHECK_CO2_MODE              1035
#define IDC_EDIT_PH_HIGH                1036
#define IDC_EDIT_PH_LOW                 1037
#define IDC_EDIT_CO2_START              1038
#define IDC_EDIT_CO2_STOP               1039
#define IDC_COMBO_PERIOD                1043
#define IDC_CUSTOM_GRAF1                1044
#define IDC_CUSTOM_GRAF2                1045
#define IDC_SLIDER_FREQ                 1046
#define IDC_EDIT_FREQ                   1047
#define IDC_CUSTOM_GRAF3                1048
#define IDC_SPIN_LAMP1_T1_SET           1049
#define IDC_EDIT_LAMP1_T1_SET           1050
#define IDC_EDIT_LAMP2_T1_SET           1051
#define IDC_EDIT_LAMP3_T1_SET           1052
#define IDC_EDIT_LAMP4_T1_SET           1053
#define IDC_EDIT_COMPRES_T1_SET         1054
#define IDC_EDIT_HEATER_T1_SET          1055
#define IDC_EDIT_CO2_T1_SET             1056
#define IDC_EDIT_MINERAL_T1_SET         1057
#define IDC_EDIT_COOLER_T1_SET          1058
#define IDC_EDIT_LAMP1_T2_SET           1059
#define IDC_SPIN_LAMP2_T1_SET           1060
#define IDC_SPIN_LAMP3_T1_SET           1061
#define IDC_EDIT_PH_DATA                1061
#define IDC_SPIN_LAMP4_T1_SET           1062
#define IDC_EDIT_PH_CALIBR_1            1062
#define IDC_SPIN_COMPRES_T1_SET         1063
#define IDC_EDIT_PH_CALIBR_2            1063
#define IDC_SPIN_HEATER_T1_SET          1064
#define IDC_EDIT_LAST_K1                1064
#define IDC_SPIN_CO2_T1_SET             1065
#define IDC_EDIT_LAST_K2                1065
#define IDC_SPIN_MINERAL_T1_SET         1066
#define IDC_EDIT_NEW_K1                 1066
#define IDC_SPIN_COOLER_T1_SET          1067
#define IDC_EDIT_NEW_K2                 1067
#define IDC_EDIT_LAMP1_T1_STOP          1068
#define IDC_EDIT_PH_1                   1068
#define IDC_EDIT_LAMP2_T1_STOP          1069
#define IDC_EDIT_PH_2                   1069
#define IDC_EDIT_LAMP3_T1_STOP          1070
#define IDC_BUTTON_CALC_K1              1070
#define IDC_EDIT_LAMP4_T1_STOP          1071
#define IDC_BUTTON_CALC_K2              1071
#define IDC_EDIT_COMPRES_T1_STOP        1072
#define IDC_EDIT_REDOX_DATA             1072
#define IDC_EDIT_HEATER_T1_STOP         1073
#define IDC_EDIT_REDOX_CALIBR           1073
#define IDC_EDIT_CO2_T1_STOP            1074
#define IDC_EDIT_MINERAL_T1_STOP        1075
#define IDC_BUTTON_CALC_K               1075
#define IDC_EDIT_COOLER_T1_STOP         1076
#define IDC_SPIN_LAMP1_T1_STOP          1077
#define IDC_EDIT_LAST_K                 1077
#define IDC_SPIN_LAMP2_T1_STOP          1078
#define IDC_EDIT_NEW_K                  1078
#define IDC_SPIN_LAMP3_T1_STOP          1079
#define IDC_BUTTON_SEND_MC              1079
#define IDC_SPIN_LAMP4_T1_STOP          1080
#define IDC_SPIN_COMPRES_T1_STOP        1081
#define IDC_SPIN_HEATER_T1_STOP         1082
#define IDC_SPIN_CO2_T1_STOP            1083
#define IDC_SPIN_MINERAL_T1_STOP        1084
#define IDC_SPIN_COOLER_T1_STOP         1085
#define IDC_EDIT_LAMP2_T2_SET           1086
#define IDC_EDIT_LAMP3_T2_SET           1087
#define IDC_EDIT_LAMP4_T2_SET           1088
#define IDC_EDIT_COMPRES_T2_SET         1089
#define IDC_EDIT_HEATER_T2_SET          1090
#define IDC_EDIT_CO2_T2_SET             1091
#define IDC_EDIT_MINERAL_T2_SET         1092
#define IDC_EDIT_COOLER_T2_SET          1093
#define IDC_SPIN_LAMP1_T2_SET           1094
#define IDC_SPIN_LAMP2_T2_SET           1095
#define IDC_SPIN_LAMP3_T2_SET           1096
#define IDC_SPIN_LAMP4_T2_SET           1097
#define IDC_SPIN_COMPRES_T2_SET         1098
#define IDC_SPIN_HEATER_T2_SET          1099
#define IDC_SPIN_CO2_T2_SET             1100
#define IDC_SPIN_MINERAL_T2_SET         1101
#define IDC_SPIN_COOLER_T2_SET          1102
#define IDC_EDIT_LAMP1_T2_STOP          1103
#define IDC_EDIT_LAMP2_T2_STOP          1104
#define IDC_EDIT_LAMP3_T2_STOP          1105
#define IDC_EDIT_LAMP4_T2_STOP          1106
#define IDC_EDIT_COMPRES_T2_STOP        1107
#define IDC_EDIT_HEATER_T2_STOP         1108
#define IDC_EDIT_CO2_T2_STOP            1109
#define IDC_EDIT_MINERAL_T2_STOP        1110
#define IDC_EDIT_COOLER_T2_STOP         1111
#define IDC_SPIN_LAMP1_T2_STOP          1112
#define IDC_SPIN_LAMP2_T2_STOP          1113
#define IDC_SPIN_LAMP3_T2_STOP          1114
#define IDC_SPIN_LAMP4_T2_STOP          1115
#define IDC_SPIN_COMPRES_T2_STOP        1116
#define IDC_SPIN_HEATER_T2_STOP         1117
#define IDC_SPIN_CO2_T2_STOP            1118
#define IDC_SPIN_MINERAL_T2_STOP        1119
#define IDC_SPIN_COOLER_T2_STOP         1120
#define IDC_EDIT_LAMP1_T3_SET           1121
#define IDC_EDIT_LAMP2_T3_SET           1122
#define IDC_EDIT_LAMP3_T3_SET           1123
#define IDC_EDIT_LAMP4_T3_SET           1124
#define IDC_EDIT_COMPRES_T3_SET         1125
#define IDC_EDIT_HEATER_T3_SET          1126
#define IDC_EDIT_CO2_T3_SET             1127
#define IDC_EDIT_MINERAL_T3_SET         1128
#define IDC_EDIT_COOLER_T3_SET          1129
#define IDC_SPIN_LAMP1_T3_SET           1130
#define IDC_SPIN_LAMP2_T3_SET           1131
#define IDC_SPIN_LAMP3_T3_SET           1132
#define IDC_SPIN_LAMP4_T3_SET           1133
#define IDC_SPIN_COMPRES_T3_SET         1134
#define IDC_SPIN_HEATER_T3_SET          1135
#define IDC_SPIN_CO2_T3_SET             1136
#define IDC_SPIN_MINERAL_T3_SET         1137
#define IDC_SPIN_COOLER_T3_SET          1138
#define IDC_EDIT_LAMP1_T3_STOP          1139
#define IDC_EDIT_LAMP2_T3_STOP          1140
#define IDC_EDIT_LAMP3_T3_STOP          1141
#define IDC_EDIT_LAMP4_T3_STOP          1142
#define IDC_EDIT_COMPRES_T3_STOP        1143
#define IDC_EDIT_HEATER_T3_STOP         1144
#define IDC_EDIT_CO2_T3_STOP            1145
#define IDC_EDIT_MINERAL_T3_STOP        1146
#define IDC_EDIT_COOLER_T3_STOP         1147
#define IDC_SPIN_LAMP1_T3_STOP          1148
#define IDC_SPIN_LAMP2_T3_STOP          1149
#define IDC_SPIN_LAMP3_T3_STOP          1150
#define IDC_SPIN_LAMP4_T3_STOP          1151
#define IDC_SPIN_COMPRES_T3_STOP        1152
#define IDC_SPIN_HEATER_T3_STOP         1153
#define IDC_SPIN_CO2_T3_STOP            1154
#define IDC_SPIN_MINERAL_T3_STOP        1155
#define IDC_SPIN_COOLER_T3_STOP         1156
#define IDC_BUTTON1                     1157
#define IDC_BUTTON_READ_MC              1158
#define IDC_CLOSE_PORT                  1159
#define IDC_FIND_PORT                   1160
#define IDC_COMBO_PORT                  1161
#define IDC_EDIT_BAUDRATE               1162
#define IDC_EDIT_NUM_PORTS              1163
#define IDC_OPEN_PORT                   1164
#define IDC_EDIT_LED_STOP               1165
#define IDC_EDIT_LED_START              1166
#define IDC_STATIC_GROUP                1167
#define IDC_STATIC_TEMP                 1167
#define IDC_STATIC_WATER_PARAM          1168
#define IDC_STATIC_DS1307               1169
#define IDC_STATIC_DEVICE_SELECT        1170
#define IDC_STATIC_COM                  1171
#define IDC_STATIC_LED                  1172
#define IDC_CHECK_COOLER_INC            1173
#define IDC_EDIT_COOLER_START           1174
#define IDC_EDIT_COOLER_STOP            1175
#define IDC_STATIC_COOLER               1176
#define IDC_STATIC_OPTION               1177
#define IDC_BUTTON_SAVE_SEND            1178
#define IDC_BUTTON_READ                 1179
#define IDC_STATIC_TEMP_MODE            1180
#define IDC_STATIC_MINERAL_MODE         1181
#define IDC_STATIC_PRODUV_MODE          1181
#define IDC_STATIC_PH_MODE              1182
#define IDC_EDIT_MINERAL_START          1183
#define IDC_EDIT_MINERAL_STOP           1184
#define IDC_EDIT_PRODUV_DLIT            1184
#define IDC_SPIN_MINERAL_START          1185
#define IDC_SPIN_MINERAL_STOP           1186
#define IDC_SPIN_PRODUV_DLIT            1186
#define IDC_STATIC_DEVICE               1188
#define IDC_STATIC_TIMER1               1189
#define IDC_STATIC_TIMER2               1190
#define IDC_STATIC_TIMER3               1191
#define IDC_STATIC_CALIBR_PH            1192
#define IDC_STATIC_CALIBR_REDOX         1193
#define IDC_STATIC_CALC_KOEF            1194
#define IDC_STATIC_                     1195
#define IDC_STATIC_CALIBR               1195
#define IDC_STATIC_DOLIV                1195
#define IDC_STATIC_SET_KOEF             1196
#define IDC_STATIC_NEW_KOEF             1197
#define IDC_STATIC_REDOX_SET_KOEF       1198
#define IDC_STATIC_REDOX_NEW_KOEF       1199
#define IDC_STATIC_DINAMIC              1200
#define IDC_STATIC_DINAMIC_TEMP         1201
#define IDC_STATIC_DINAMIC_PH           1202
#define IDC_STATIC_DINAMIC_REDOX        1203
#define IDC_EDIT1                       1204
#define IDC_EDIT_SYSTEM_TIME            1204
#define IDC_EDIT_MIN_POWER_COOLER       1204
#define IDC_LIST1                       1205
#define IDC_LIST_RECIVE                 1205
#define IDC_LIST_DATA                   1205
#define IDC_COMBO_TEMP_SENSOR           1206
#define IDC_STATIC_DOP_PARAM            1207
#define IDC_BUTTON_LED_SET              1208
#define IDC_BUTTON_COOLER_SET           1209
#define IDC_CHECK_PRODUV                1210
#define IDC_SLIDER_GRAF                 1211
#define IDC_CHECK_TRAY                  1212
#define IDC_CHECK_SAVE_EEPROM           1213
#define IDC_CHECK_TIME_COMPARE          1214
#define IDC_COMBO_COM_PORT_NUM          1215
#define IDC_CHECK_COM_PORT_OPEN         1216
#define IDC_STATIC_MAIN_OPTION          1217
#define IDC_CHECK_DOLIV                 1218
#define IDC_BUTTON_POROG1               1219
#define IDC_BUTTON_POROG2               1220
#define IDC_PROGRESS1                   1221
#define IDC_PROGRESS_DOLIV              1221
#define IDC_BUTTON_EVENT_PARAM          1222
#define ID_32771                        32771
#define ID_RECIEVE_DATA                 32772
#define ID_POPUP_32773                  32773
#define ID_POPUP_32774                  32774
#define ID_POPUP_32775                  32775
#define ID_POPUP_32776                  32776
#define ID_DEMO_MINIMISE                32777
#define ID_DEMO_MAXIMISE                32778
#define ID_32779                        32779
#define ID_SPRAVKA                      32780
#define ID_32781                        32781
#define ID_TRAY                         32782

// Next default values for new objects
// 
#ifdef APSTUDIO_INVOKED
#ifndef APSTUDIO_READONLY_SYMBOLS
#define _APS_NEXT_RESOURCE_VALUE        142
#define _APS_NEXT_COMMAND_VALUE         32783
#define _APS_NEXT_CONTROL_VALUE         1224
#define _APS_NEXT_SYMED_VALUE           101
#endif
#endif
