Stan1806/AquaController_2014/Sources/AquaControl 2014 (MFC)/AquaControl 2014/stdafx.cpp

// stdafx.cpp : source file that includes just the standard includes
// AquaControl 2014.pch will be the pre-compiled header
// stdafx.obj will contain the pre-compiled type information

#include "stdafx.h"
